virgilm/tentacle-raspi-oshw/hardware/KiCad/tentacle-raspi.kicad_pcb

## KiCad design hardware/KiCad/tentacle-raspi.kicad_pcb (2022-02-06)

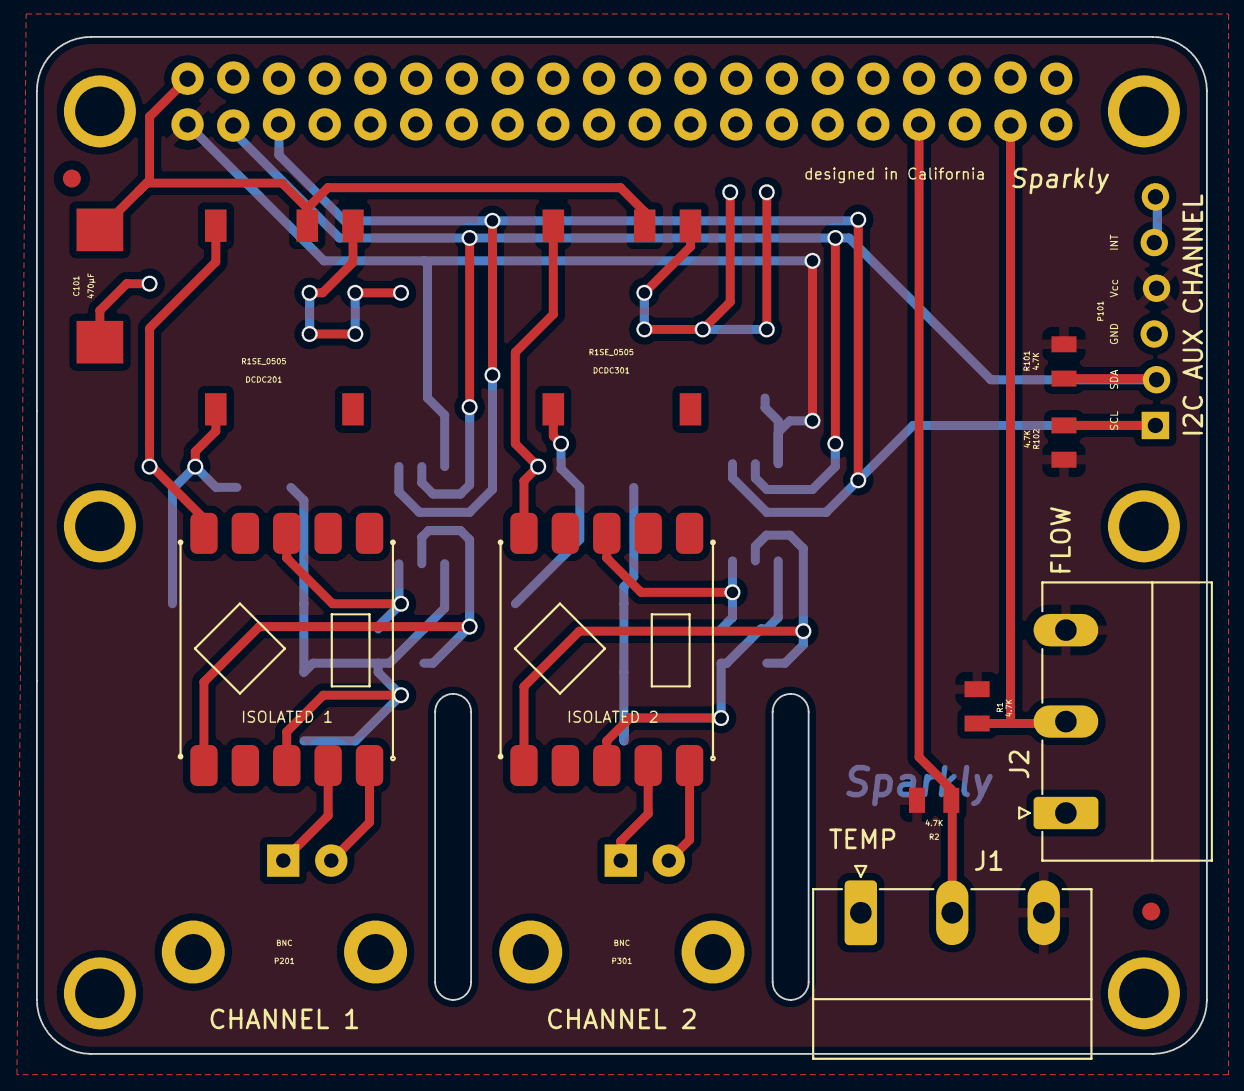
[picture p1: board tentacle-raspi.kicad_pcb from above]

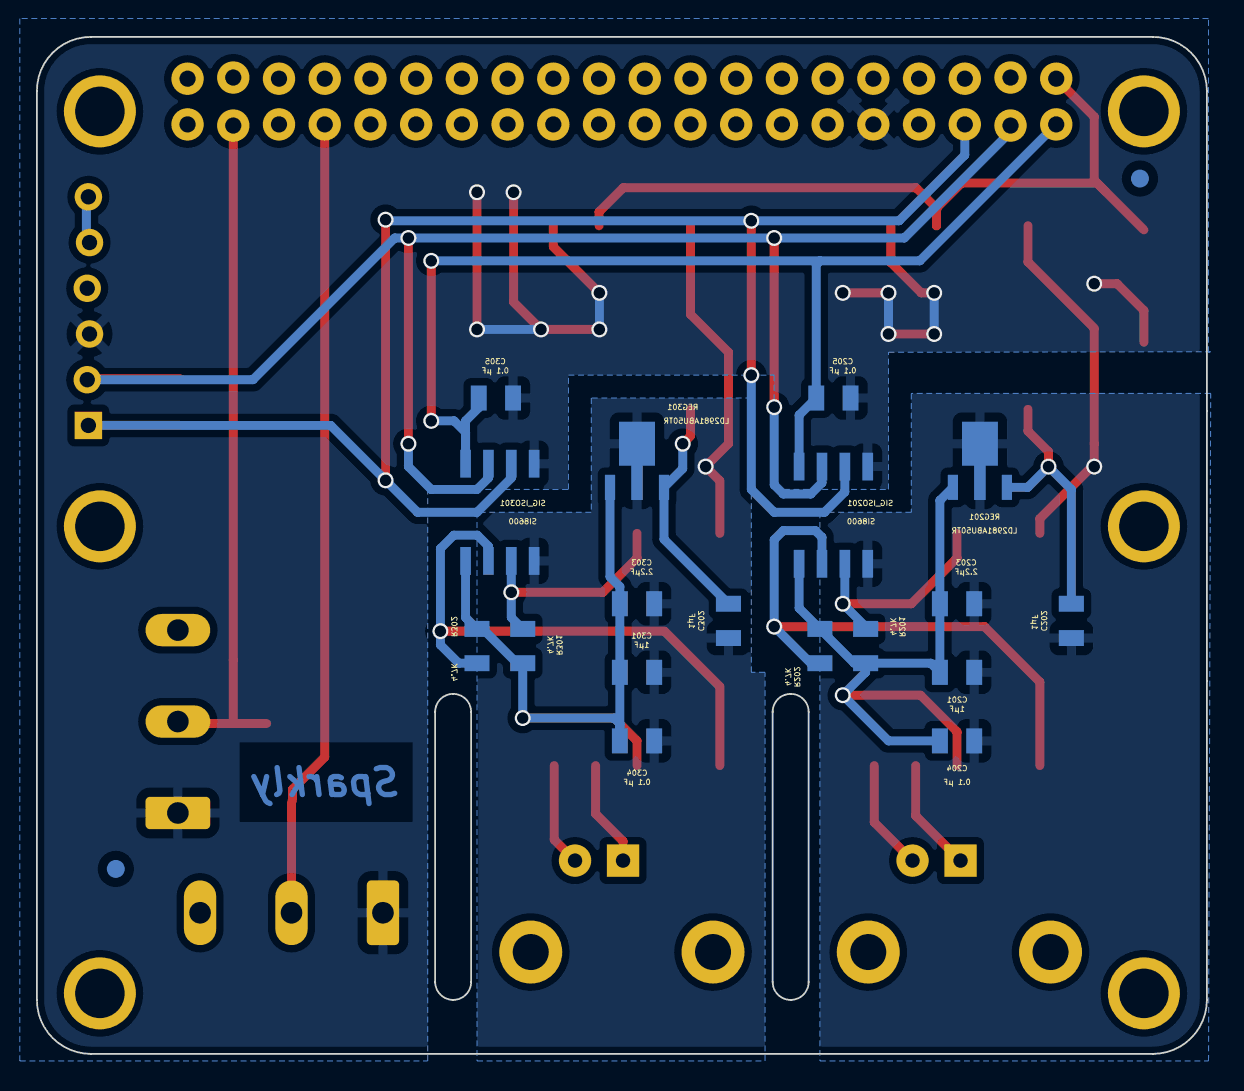
[picture p2: board tentacle-raspi.kicad_pcb from below]

Board: 2 copper layers, 65.0 x 56.5 mm, 38 parts (20 on the bottom side), 22 nets.

Parts:
C101: 470µF; WL-CASE-X-2917
C201, C202, C301, C302: 1µF; WL-SM0805C
C203, C303: 2.2µF; WL-SM0805C
C204, C205, C304, C305: 0.1 µF; WL-SM0805C
DCDC201, DCDC301: R1SE_0505; WL-R1SE-0505
J1, J2: Conn_01x03; PhoenixContact_MC_1,5_3-G-5.08_1x03_P5.08mm_Horizontal
P101: CONN_01X06; WL-PINH_1X6_snk
P201, P301: BNC; WL-EB08040502_snk
PI_BOARD101: RASPBERRY_PI_2; WL-40pin_snk
PI_Board: VAL**; WL-PI_Board_no_outline
R1, R2, R101, R102, R201, R202, R301, R302: 4.7K; WL-SM0805R
REG201, REG301: LD2981ABU50TR; WL-SOT89
SIG_ISO201, SIG_ISO301: SI8600; WL-SOIC8N
STP201, STP301: EZO_SMD; WL-ezo-smd
fiducial: VAL**; WL-fiducial_1mm
fiducial#2, fiducial#3, fiducial#4: VAL**; WL-fiducial_1mm

Connections:
+3.3V: C205.1, C305.1, J1.3, J2.3, P101.4, PI_BOARD101.1 (3.3v), R1.2, R2.2, R101.2, R102.2, SIG_ISO201.8 (BVCC), SIG_ISO301.8 (BVCC)
/SCL: P101.1, PI_BOARD101.5 (GPIO03_(SCL_I2C)), R102.1, SIG_ISO201.6 (BSCL), SIG_ISO301.6 (BSCL)
/SDA: P101.2, PI_BOARD101.3 (GPIO02_(SDA_I2C)), R101.1, SIG_ISO201.7 (BSDA), SIG_ISO301.7 (BSDA)
/nonisolated1/FLOW: J2.2, PI_BOARD101.37 (GPIO26), R1.1
/nonisolated1/TEMP: J1.2, PI_BOARD101.33 (GPIO13), R2.1
GND: C101.2, C205.2, C305.2, DCDC201.1 (GND), DCDC301.1 (GND), J1.1, J2.1, P101.3, PI_BOARD101.9 (Ground), SIG_ISO201.5 (BGND), SIG_ISO301.5 (BGND)
GND_ISO2: C201.1, C202.1, C203.1, C204.1, DCDC201.4 (GND_ISO), REG201.2 (GND), SIG_ISO201.4 (AGND), STP201.6 (GND)
GND_ISO3: C301.1, C302.1, C303.1, C304.1, DCDC301.4 (GND_ISO), REG301.2 (GND), SIG_ISO301.4 (AGND), STP301.6 (GND)
unnamed: C202.2, DCDC201.5 (V_ISO), REG201.3 (Vin)
unnamed: C302.2, DCDC301.5 (V_ISO), REG301.3 (Vin)
unnamed: P101.5, P101.6
unnamed: P201.1 (In), STP201.4 (PRB)
unnamed: P201.2 (Ext), STP201.5 (PRB_GND)
unnamed: P301.1 (In), STP301.4 (PRB)
unnamed: P301.2 (Ext), STP301.5 (PRB_GND)
unnamed: R201.2, SIG_ISO201.3 (ASCL), STP201.8 (SCL)
unnamed: R202.2, SIG_ISO201.2 (ASDA), STP201.1 (SDA)
unnamed: R301.2, SIG_ISO301.3 (ASCL), STP301.8 (SCL)
unnamed: R302.2, SIG_ISO301.2 (ASDA), STP301.1 (SDA)
VCC: C101.1, DCDC201.2 (VCC), DCDC301.2 (VCC), PI_BOARD101.2 (5v)
V_ISO2: C201.2, C203.2, C204.2, R201.1, R202.1, REG201.1 (Vout), SIG_ISO201.1 (AVCC), STP201.3 (VCC)
V_ISO3: C301.2, C303.2, C304.2, R301.1, R302.1, REG301.1 (Vout), SIG_ISO301.1 (AVCC), STP301.3 (VCC)
