virgilm/tentacle-raspi-oshw/(commit log)

2022-01-13 Modified to use OEM sensors.
    Moved most components to the other side.
    Created a new symbol and footprint.
    [isolation-2022-01-11-19-24-06.sch, isolation.kicad_sch, nonisolated-2022-01-11-19-24-06.sch, nonisolated.kicad_sch, tentacle-raspi-2022-01-11-19-24-06.sch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]
2022-02-03 Version 2.0
    1wire sensor
    flow sensor
    [nonisolated.kicad_sch, tentacle-raspi.kicad_pcb, tentacle-raspi.kicad_sch]
2022-02-06 V3, 1wire Temp sensor and flow sensor.
    [tentacle-raspi-B.Cu.gbr, tentacle-raspi-B.Mask.gbr, tentacle-raspi-B_Cu.gbl, tentacle-raspi-B_Mask.gbs, tentacle-raspi-B_Silkscreen.gbo, tentacle-raspi-B_Silkscreen.gbr, tentacle-raspi-Edge.Cuts.gbr, tentacle-raspi-Edge_Cuts.gbr]
2022-08-16 V4
    - Corrected GND issue.
    - Separate PRB GND.
    - Enlarged J1,J2 holes to 1.3mm from 1.2mm
    [tentacle-raspi-B_Cu.gbl, tentacle-raspi-B_Mask.gbs, tentacle-raspi-B_Silkscreen.gbo, tentacle-raspi-Edge_Cuts.gm1, tentacle-raspi-F_Cu.gtl, tentacle-raspi-F_Mask.gts, tentacle-raspi-F_Silkscreen.gto, tentacle-raspi-PTH.drl]
